jmagdika/uaefiPROBA/(commit log)

2025-08-20 Trigger Gerber generation workflow
2025-08-20 [skip actions] Auto-generated board v2.1
    [uaefi-B_Cu.gbl, uaefi-B_Mask.gbs, uaefi-B_Paste.gbp, uaefi-B_Silkscreen.gbo, uaefi-Edge_Cuts.gm1, uaefi-F_Cu.gtl, uaefi-F_Mask.gts, uaefi-F_Paste.gtp]
